rafaeloliva/AEA-DataAcq/SISMEDRG24/v2021-CR1000-RBpi4-Ardu-TB/Papers/CASE2021/PresentCASE2021-Castello+Oliva01-11-21c.pdf

# Vinculación de un sistema de medición con Modbus a través de un enlace MQTT/TLS a un servidor

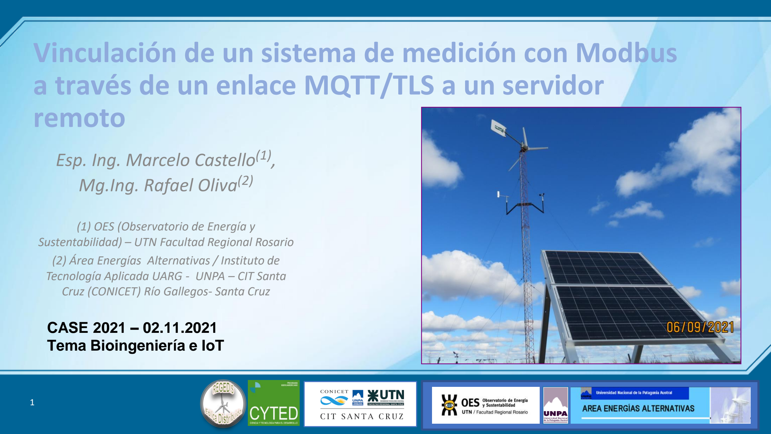
[picture p21: page 1]

1

# remoto

# Esp. Ing. Marcelo Castello⁽¹⁾

,

# Mg.Ing. Rafael Oliva⁽²⁾

## (1) OES (Observatorio de Energía y Sustentabilidad) – UTN Facultad Regional Rosario (2) Área Energías Alternativas / Instituto de Tecnología Aplicada UARG - UNPA – CIT Santa Cruz (CONICET) Río Gallegos- Santa Cruz

## CASE 2021 – 02.11.2021 Tema Bioingeniería e IoT

CASE 2021 – PAPER OES/UNPA 2

# Resumen

- EN ESTE TRABAJO SE PRESENTA LA VINCULACION ENTRE UN DATALOGGER Y UN DASHBOARD CENTRALIZADO.
- EL DATALOGGER, INSTALADO EN EL CAMPUS UNPA-UARG TOMA:
- DATOS DE VIENTO UTILIZANDO SENSORES THIES INSTALADOS EN LA MISMA TORRE DE UN AEROGENERADOR
- INFORMACION DE CORRIENTE PRODUCIDA POR UN CONJUNTO DE PANELES FOTOVOLTAICOS
- INFORMACION DE CORRIENTE PRODUCIDA POR UN AEROGENERADOR DE 1 KW, Y TENSIÓN DE UN BANCO DE BATERÍAS DE 24 V
- EL SISTEMA, A TRAVÉS DE UN INVERTER PROPORCIONA 220 V CA A UN INVERNADERO EDUCATIVO
- SE CONSTRUYÓ UN MÓDULO AUXILIAR EXTERNO PARA MEDICION DE TEMPERATURA Y HUMEDAD EN EL INVERNADERO, COMUNICADO POR RS485 Y PROTOCOLO MODBUS RTU CON EL DATALOGGER PRINCIPAL.
- EL DATALOGGER ENVÍA LOS DATOS A TRAVES DE MODBUS/TCP A UNA RASPBERRY PI 4B QUE CONVIERTE ESTE PROTOCOLO A MQTT/TLS PARA DAR SEGURIDAD A LA TRANSMISION DE LOS DATOS, YA QUE EL SERVIDOR CON EL DASHBOARD SE ENCUENTRA FUERA DE LA RED DE CAMPO.
- SE REALIZA UN ANÁLISIS DE LA PERFORMANCE DEL SISTEMA HÍBRIDO EÓLICO-SOLAR DE BAJA POTENCIA

# Diagramas

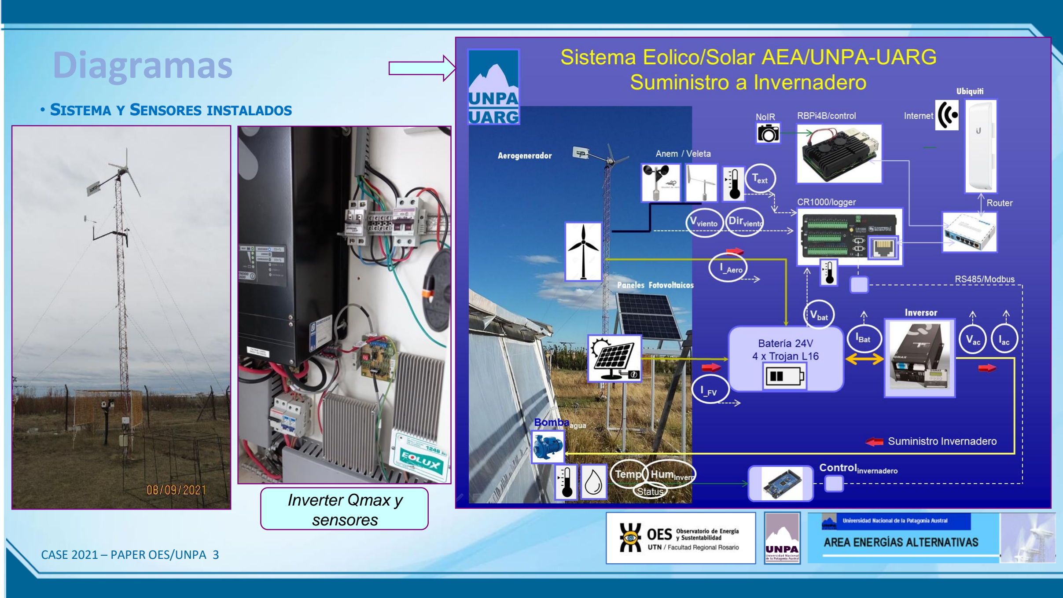
[picture p22: page 3]

- SISTEMA Y SENSORES INSTALADOS

### Inverter Qmax y sensores

# Diagramas

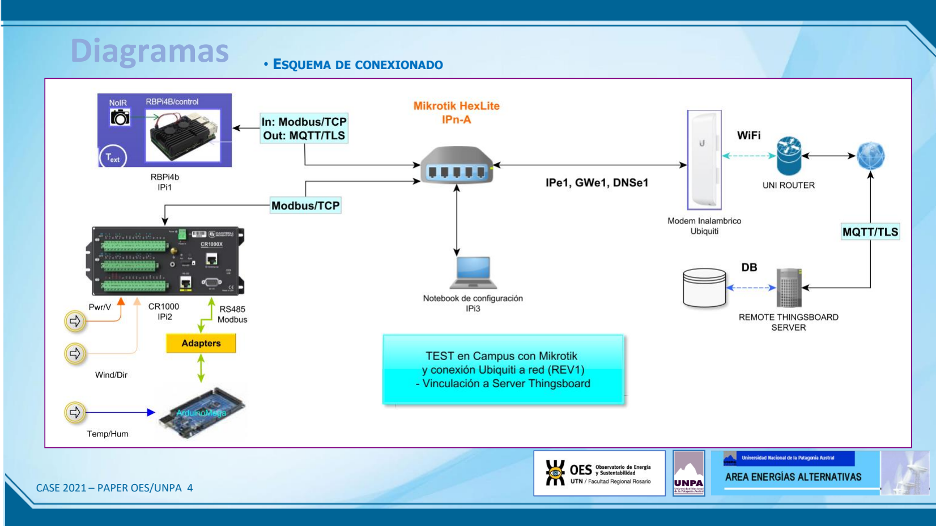
[picture p23: page 4]

- ESQUEMA DE CONEXIONADO

# Implementación

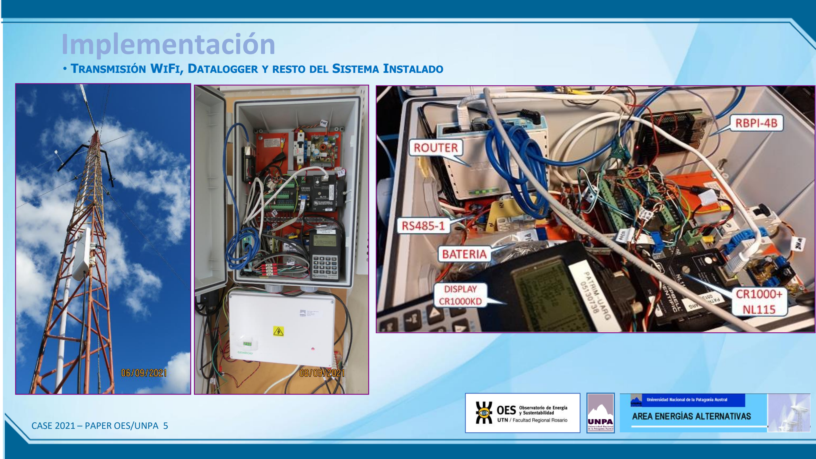
[picture p24: page 5]

- TRANSMISIÓN WIFI, DATALOGGER Y RESTO DEL SISTEMA INSTALADO

# Implementación

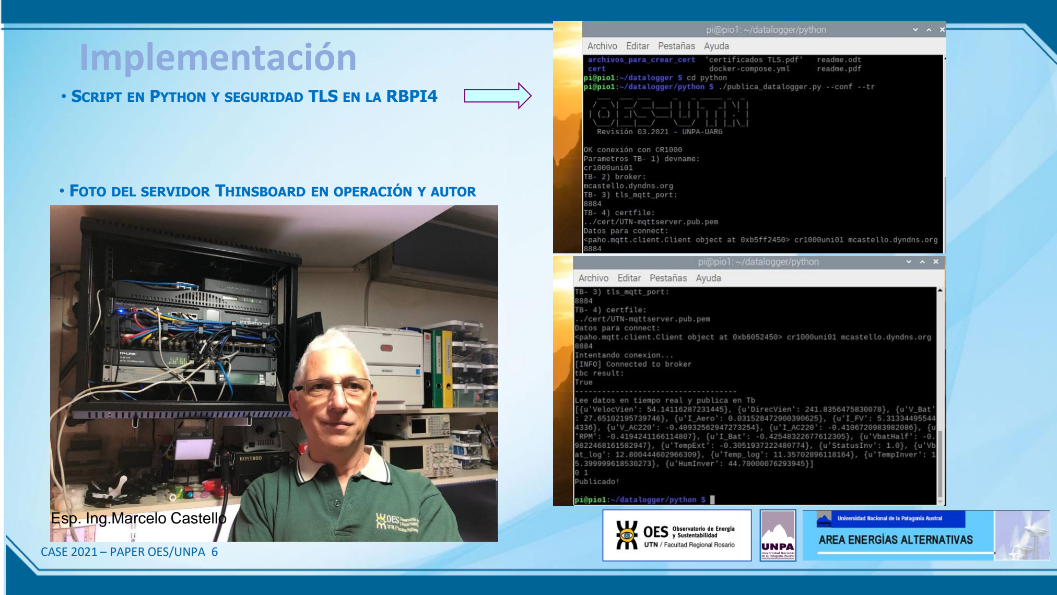
[picture p25: page 6]

- SCRIPT EN PYTHON Y SEGURIDAD TLS EN LA RBPI4
- FOTO DEL SERVIDOR THINSBOARD EN OPERACIÓN Y AUTOR

Esp. Ing.Marcelo Castello

# Implementación

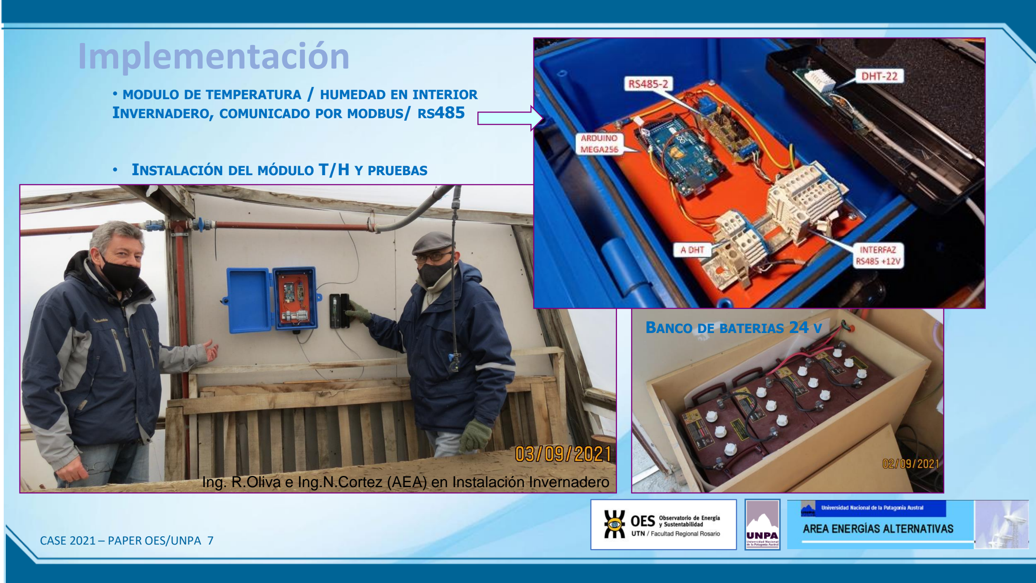
[picture p26: page 7]

- MODULO DE TEMPERATURA / HUMEDAD EN INTERIOR INVERNADERO, COMUNICADO POR MODBUS/ RS485
- INSTALACIÓN DEL MÓDULO T/H Y PRUEBAS

BANCO DE BATERIAS 24 V

Ing. R.Oliva e Ing.N.Cortez (AEA) en Instalación Invernadero

# Datos del panel Thingsboard

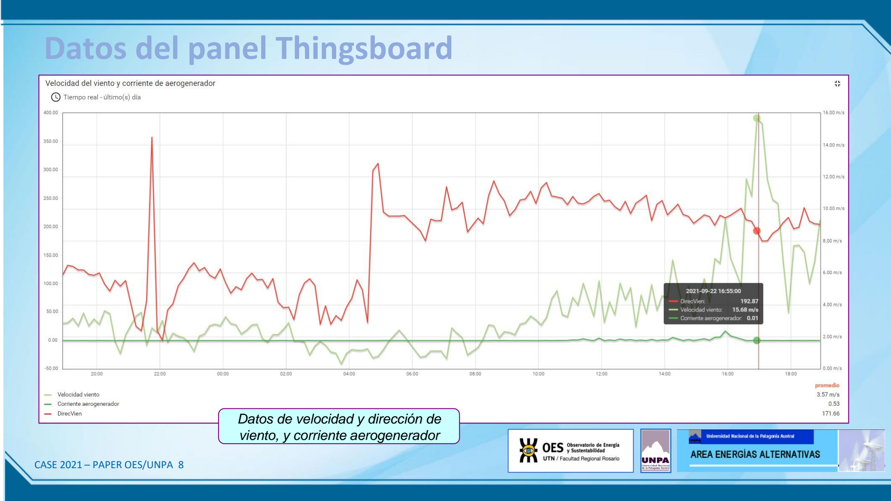
[picture p27: page 8]

- DATOS DE FUNCIONAMIENTO DEL PANEL THINGSBOARD

### Datos de velocidad y dirección de viento, y corriente aerogenerador

# Datos del panel Thingsboard

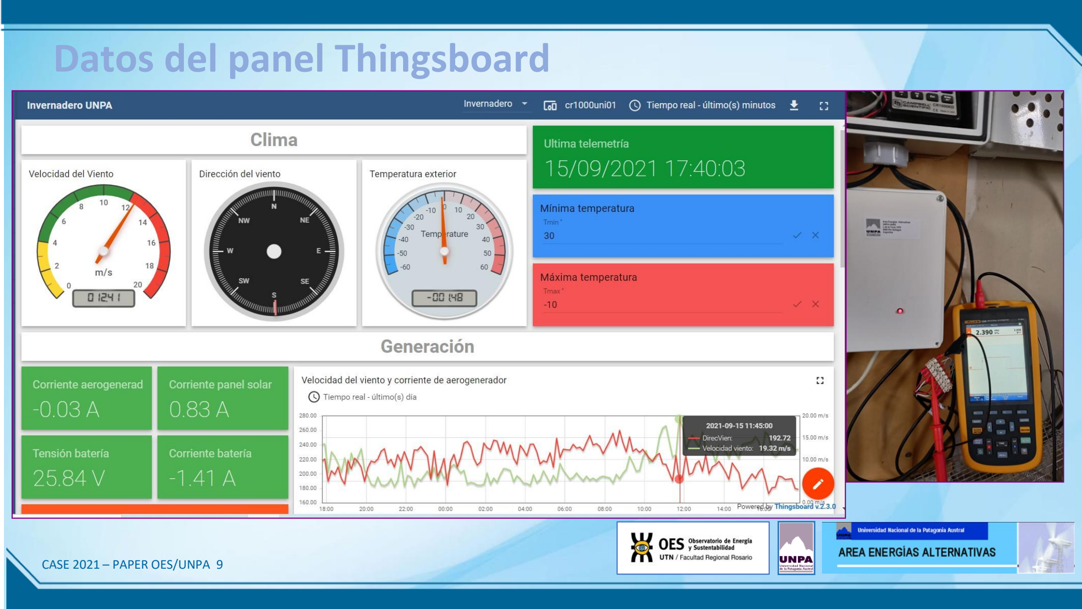
[picture p28: page 9]

- DATOS DE FUNCIONAMIENTO DEL PANEL THINGSBOARD

# Datos del panel Thingsboard

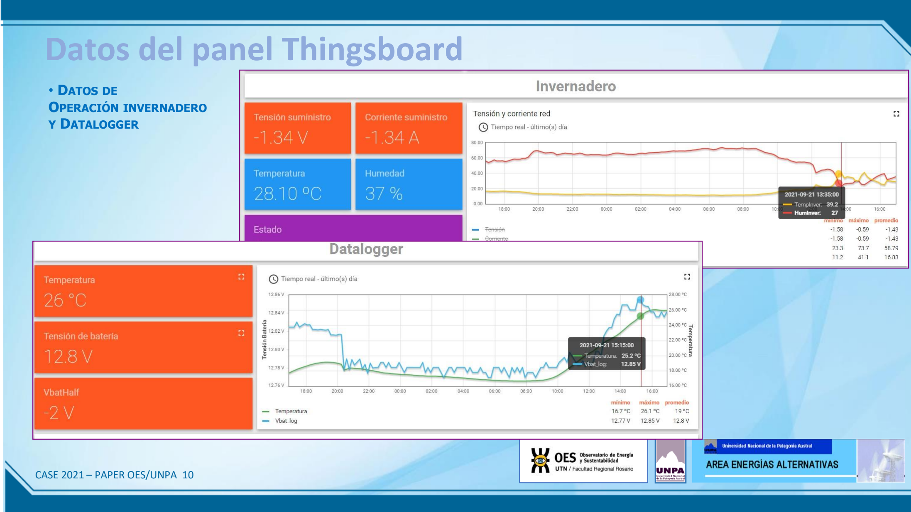
[picture p29: page 10]

- DATOS DE
OPERACIÓN INVERNADERO
Y DATALOGGER

# CONCLUSIONES

- SE HA AVANZADO EN LA IMPLEMENTACION DE UN SISTEMA PARA VINCULAR UN DATALOGGER COMERCIAL A TRAVES DE MQTT/TLS CON UN SERVIDOR REMOTO THINGSBOARD, LOGRANDO MONITOREO Y PERSISTENCIA DE DATOS PARA MEDICIÓN DEL RECURSO EÓLICO Y EL RELEVAMIENTO DE LA PERFORMANCE DE UN SISTEMA HÍBRIDO EÓLICO-SOLAR DE BAJA POTENCIA EN UN CAMPUS UNIVERSITARIO.
- SE ESPERA QUE LOS RESULTADOS CONTRIBUYAN A LA IMPLEMENTACION DE ESTE TIPO DE SISTEMAS EN

INSTALACIONES EDUCATIVAS SIMILARES

# AGRADECIMIENTOS

- LOS AUTORES AGRADECEN A LA UNPA (INSTITUTO DE TECNOLOGÍA APLICADA - UARG), AL CIT-SANTA CRUZ (CONICET) Y AL OES (OBSERVATORIO DE ENERGÍA Y SUSTENTABILIDAD) DE LA UNIVERSIDAD TECNOLÓGICA NACIONAL - FRRO (FACULTAD REGIONAL ROSARIO)
- LA VINCULACIÓN ENTRE INSTITUCIONES HA SIDO UNA CONTRIBUCIÓN IMPORTANTE DE LA RED REGEDIS / CYTED

# Referencias

[1] DATALOGGER CR1000 - CAMPBELL SCIENTIFI C CSI HTTPS://WWW.CAMPBELLSCI.COM/CR1000
[2] RASPBERRY PI 4B (2020) HTTPS://WWW.RASPBERRYPI.ORG/PRODUCTS/RASPBERRY-PI-4-MODEL-B/
[3] UBIQUITI NANOSTATION (2019) HTTPS://WWW.UI.COM/AIRMAX/NANOSTATIONM/
[4] THINGSBOARD COMMUNITY EDITION (2021) HTTPS://THINGSBOARD.IO/
[5] MIKROTIK HEXLITE ROUTERS (2021) HTTPS://MIKROTIK.COM/PRODUCT/RB750R2
[6] DIN-RS485 ADAPTORS USER GUIDE LYR ING. (2021) HTTPS: //WWW.LYRINGENIERIA.COM.AR/WP-CONTENT/UPLOADS/2021/08/USERGUIDEDINRS485BOARD V1DEN.PDF
[7] ARDUINO MODBUS STANDARD LIBRARY (2019) HTTPS://WWW.ARDUINO.CC/EN/ARDUINOMODBUS/ARDUINOMODBUS
[8] POSTGRESQL OPEN SOURCE DATABASE (2021) HTTPS://WWW.POSTGRESQL.ORG
[9] KEYTOOL - ORACLE JAVA PLATFORM TOOLS REFERENCE (2021) HTTPS://DOCS. ORACLE.COM/JAVASE/8/DOCS/TECHNOTES/TOOLS/WINDOWS/KEYTOOL.HTML
[10] FIRSTRATE SENSOR / HUNAN (2021) HTTP://WWW.FI RSTSENSOR.COM.CN/PRODUCT/110.HTML
[11] THIES FIRSTCLASS WIND SENSORS (2021) HTTPS://WWW.THIESCLIMA.COM/EN/PRODUCTS/WIND-FIRST-CLASS/

# Gracias por su atención!
