rafaeloliva/AEA-DataAcq/SISMEDRG24/v2021-CR1000-RBpi4-Ardu-TB/Papers/ReportREGEDIS/REGEDIS_Informe150322.pdf

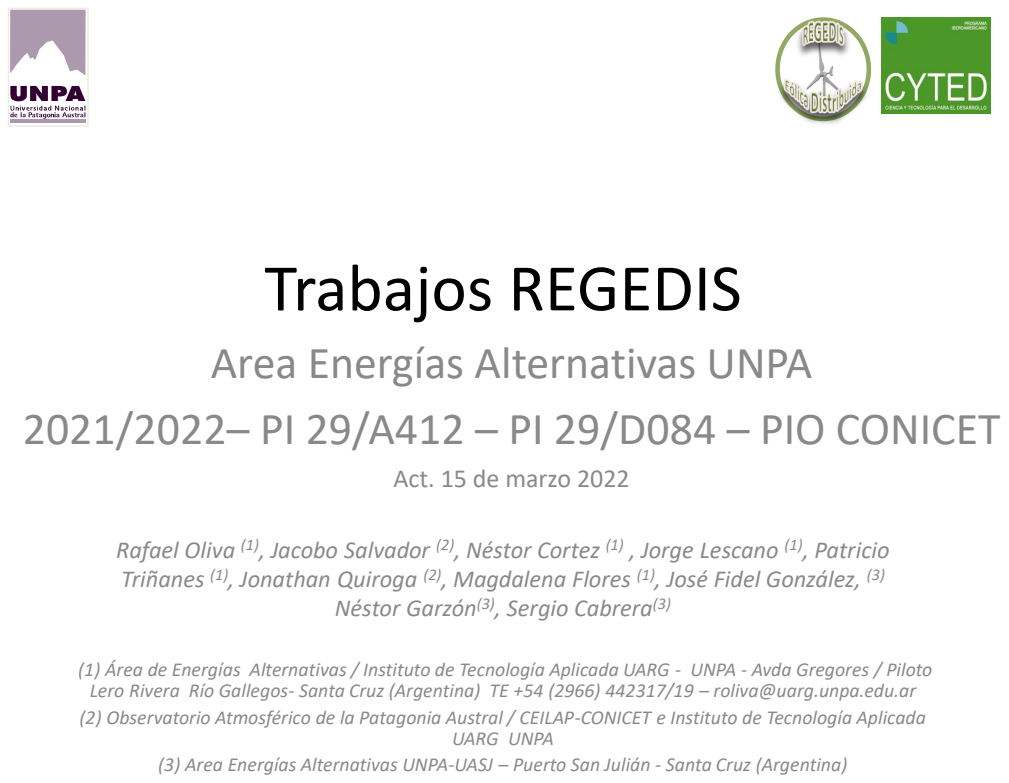
[picture p54: page 1]
UARG UNPA

Trabajos REGEDIS
Area Energías Alternativas UNPA

2021/2022– PI 29/A412 – PI 29/D084 – PIO CONICET

Act. 15 de marzo 2022

Rafael Oliva ⁽¹⁾, Jacobo Salvador ⁽²⁾, Néstor Cortez ⁽¹⁾ , Jorge Lescano ⁽¹⁾, Patricio
Triñanes ⁽¹⁾, Jonathan Quiroga ⁽²⁾, Magdalena Flores ⁽¹⁾, José Fidel González, ⁽³⁾

Néstor Garzón⁽³⁾, Sergio Cabrera⁽³⁾

(1) Área de Energías Alternativas / Instituto de Tecnología Aplicada UARG - UNPA - Avda Gregores / Piloto
Lero Rivera Río Gallegos- Santa Cruz (Argentina) TE +54 (2966) 442317/19 – roliva@uarg.unpa.edu.ar
(2) Observatorio Atmosférico de la Patagonia Austral / CEILAP-CONICET e Instituto de Tecnología Aplicada

(3) Area Energías Alternativas UNPA-UASJ – Puerto San Julián - Santa Cruz (Argentina)

# Invernadero UARG

# Ya con sensores instalados 01-22

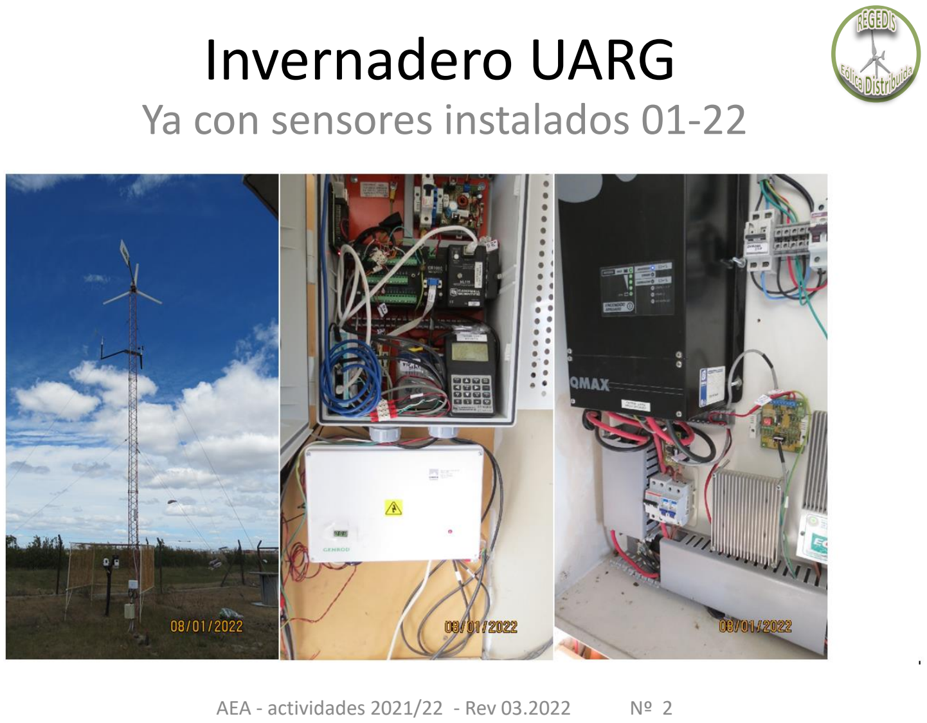
[picture p55: page 2]

AEA - actividades 2021/22 - Rev 03.2022 Nº 2

# Instrumentación

# Ensayos 1

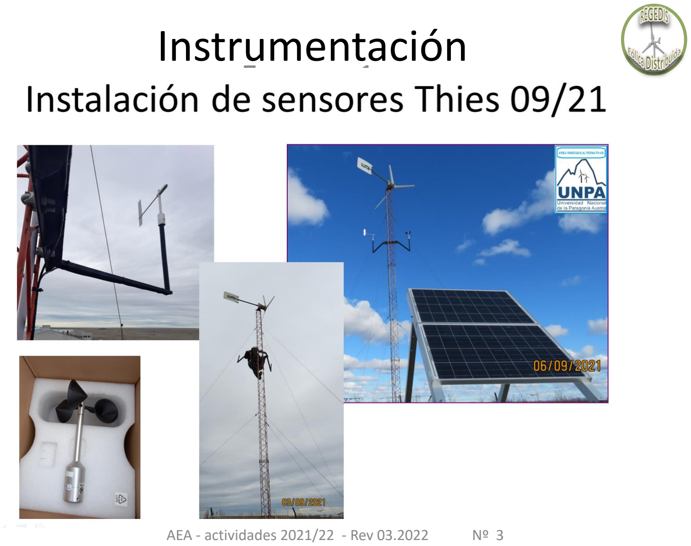
[picture p56: page 3]

# Invernadero UARG

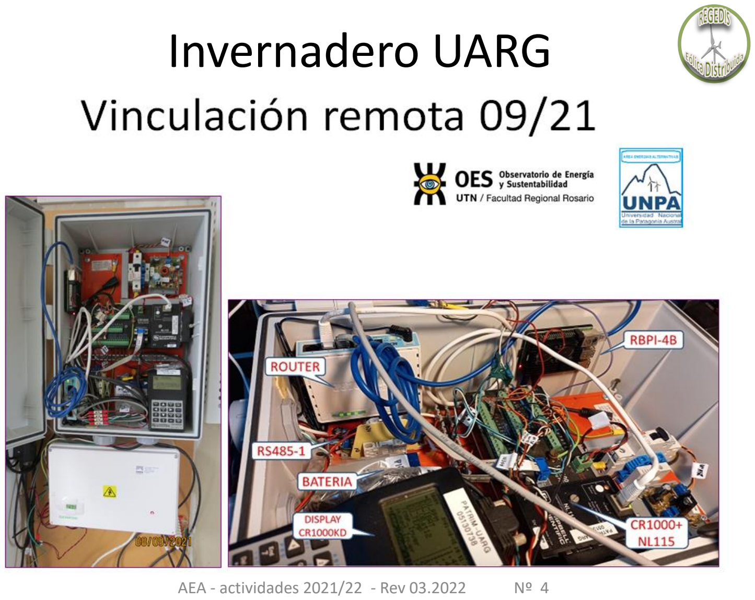
[picture p57: page 4]

## Sistema Eolico/Solar AEA/UNPA-UARG Suministro a Invernadero

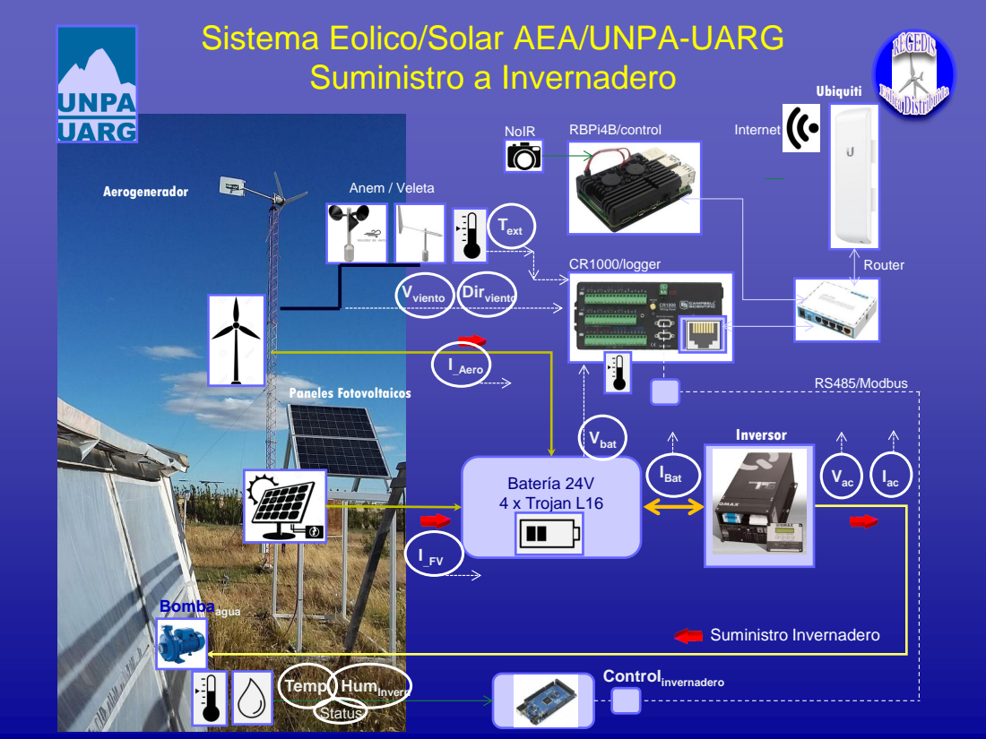
[picture p58: page 5]
Batería 24V 4 x Trojan L16; Aerogenerador; Paneles Fotovoltaicos; Inversor; I_Aero; IBat; Suministro Invernadero; Ubiquiti; RS485/Modbus; Vbat; Vac; Iac; ControIinvernadero; Bombaagua; Temp, HumInvern; CR1000/logger; Router; RBPi4B/control; Anem / Veleta; Vviento; Dirviento; Text; NoIR; Internet; Status

# Instrumentación

# Diagrama 3a

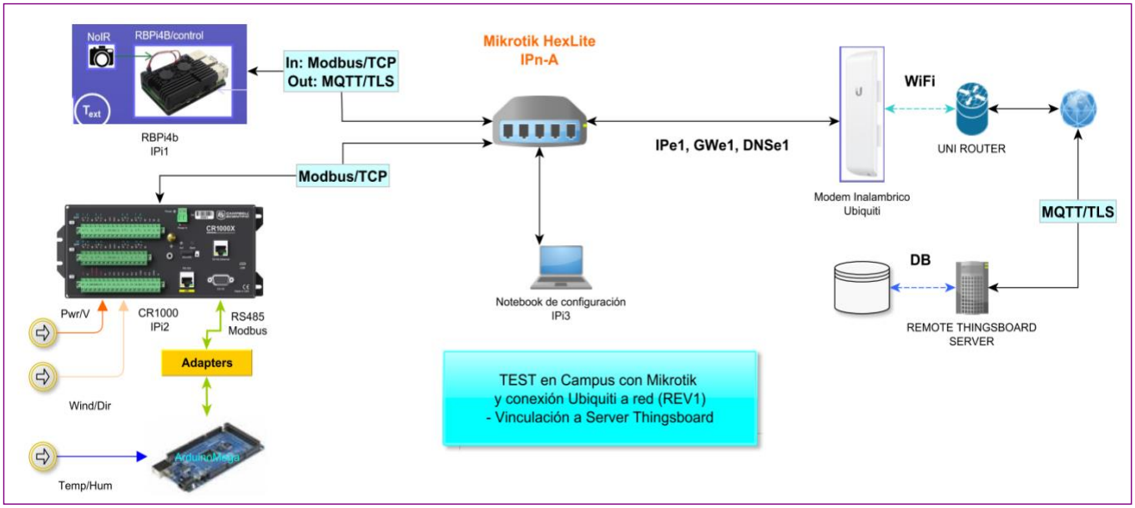
[picture p59: figure]

# Instrumentación

# Diagrama 3b

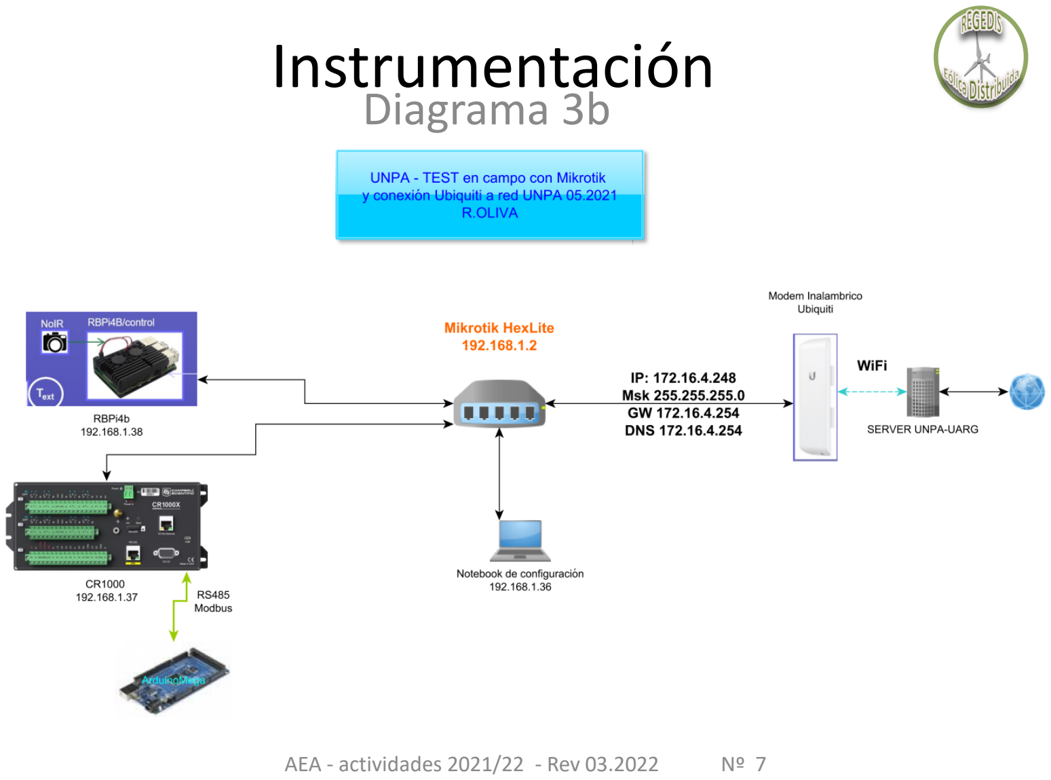
[picture p60: page 7]

# Instrumentación

# Medidor Temp/Hum RS485 a CR1000

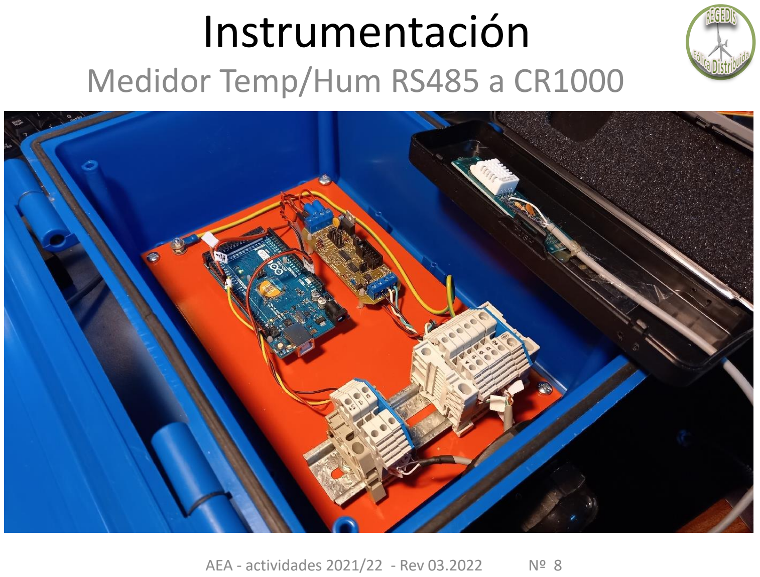
[picture p61: page 8]

# Instrumentación

# Medidor Temp/Hum y sistema bombeo

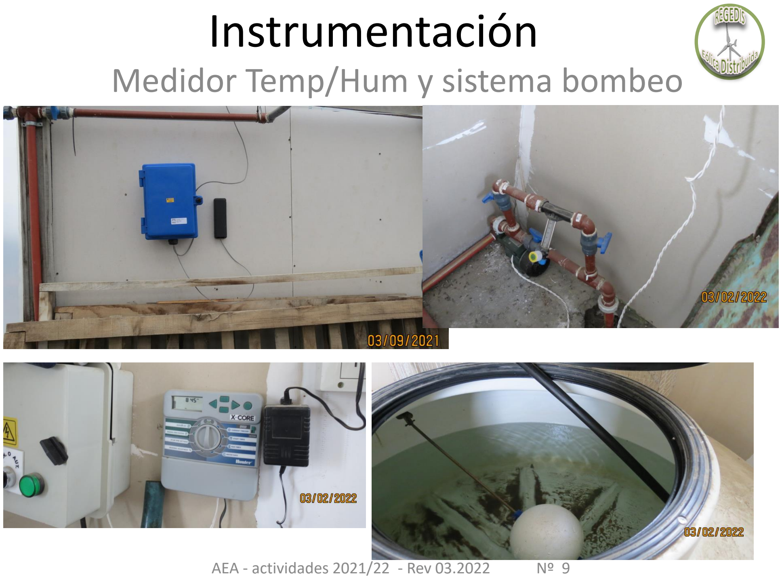
[picture p62: page 9]

# Instrumentación

# Medidor Temp/Hum RS485 a CR1000

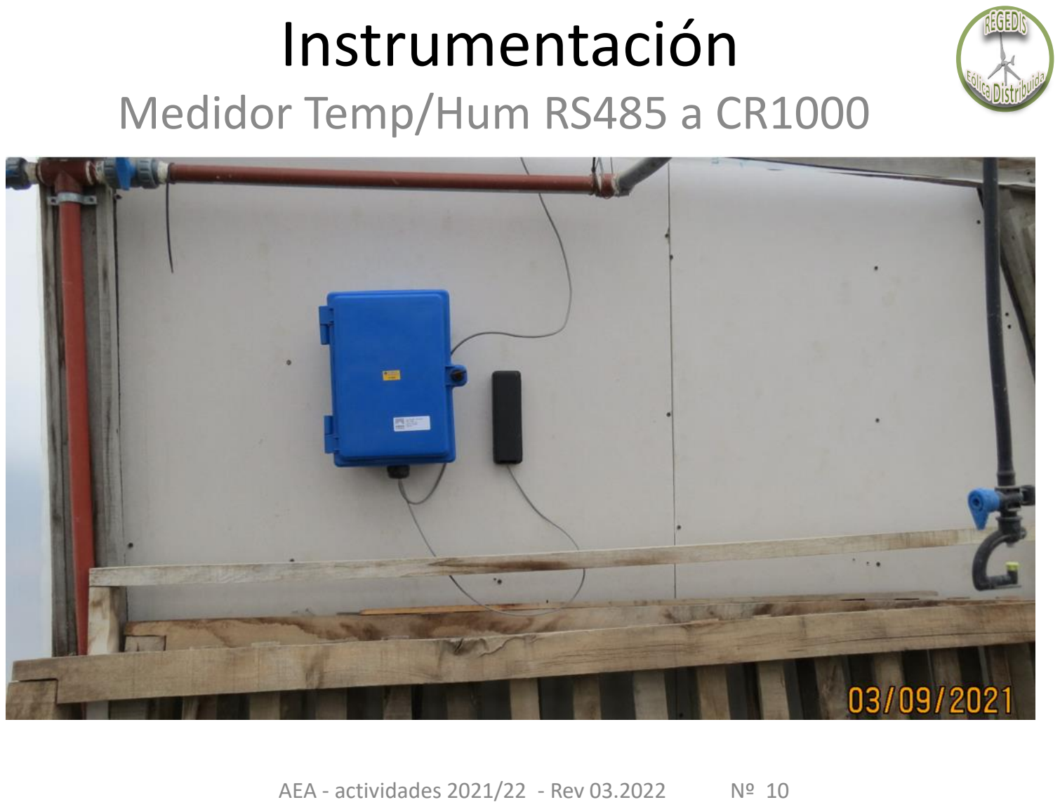
[picture p63: page 10]

# Instrumentación

# Visualizacion datos instantáneos

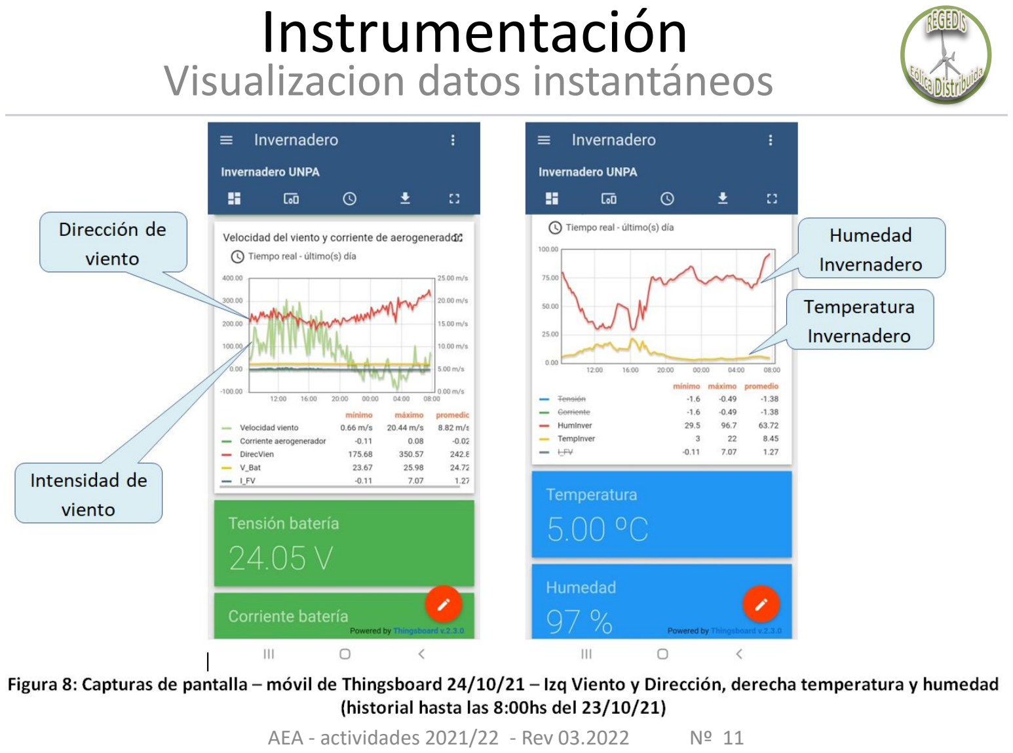
[picture p64: page 11]

# Instrumentación

# Visualización promedios de 1 minuto

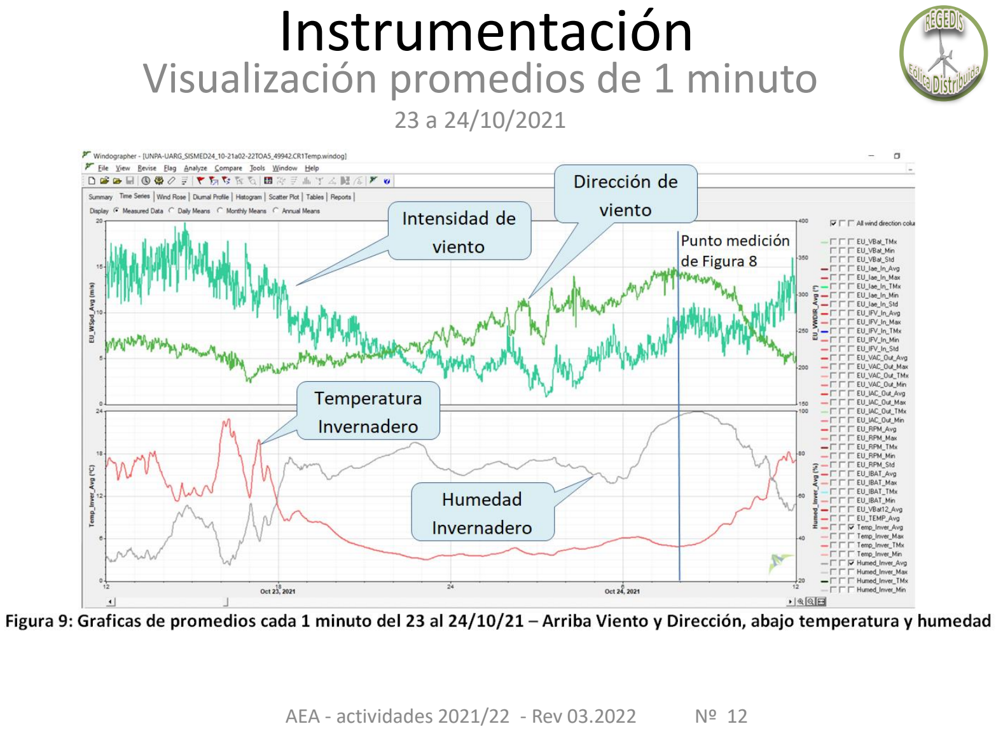
[picture p65: page 12]

23 a 24/10/2021

# Instrumentación

# Datos recientes

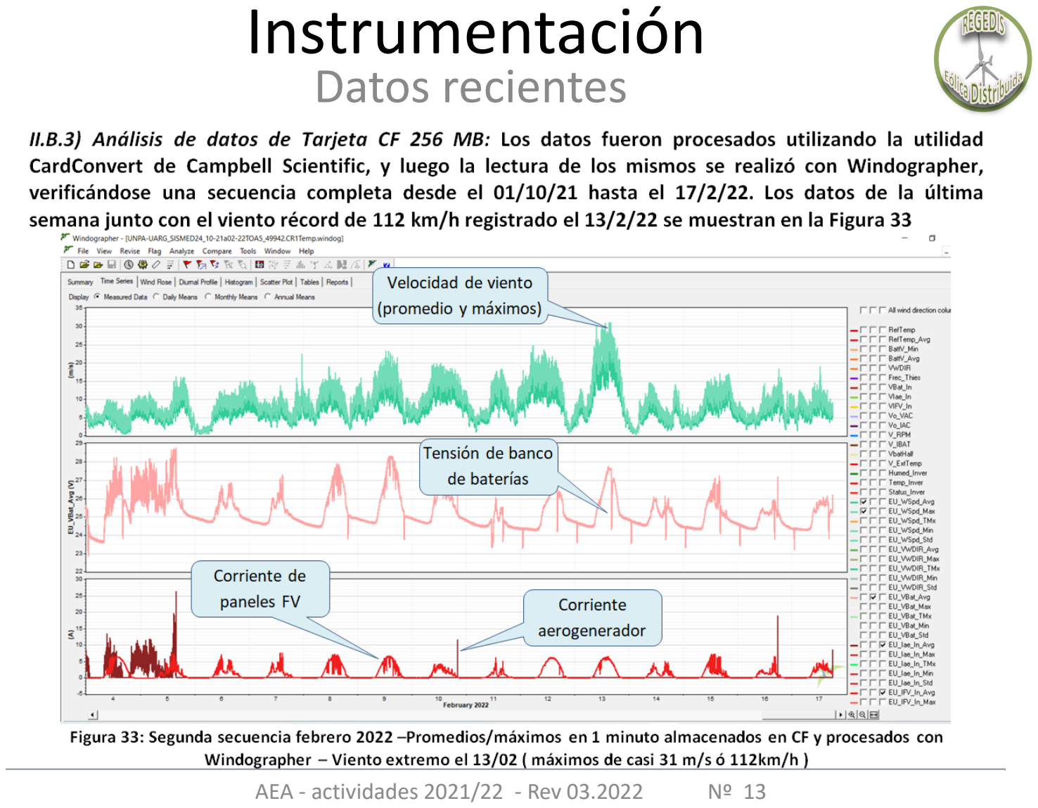
[picture p66: page 13]

# Instrumentación

# Reposición fuente RBPi4

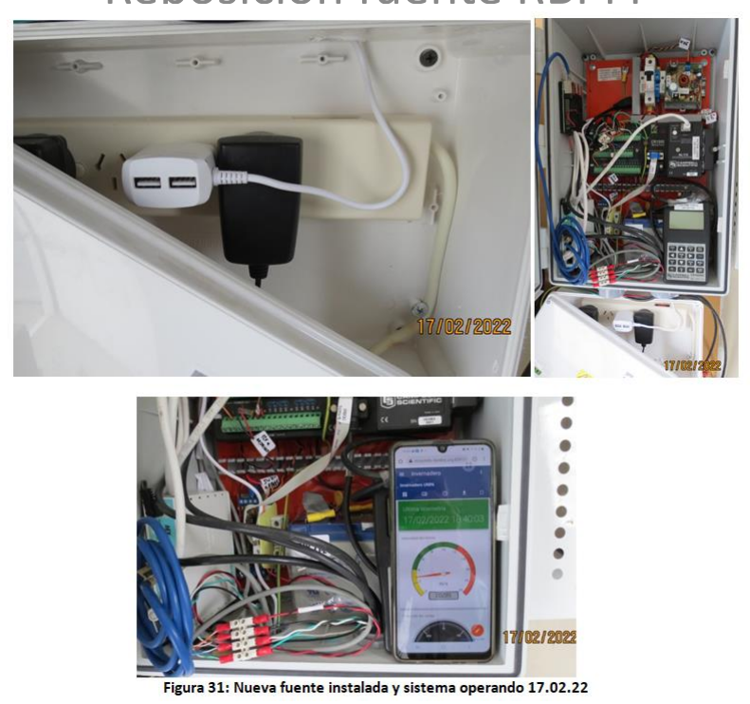
[picture p67: figure]

## Participación R. Oliva como docente en Especialización Eólica UNComa

## Pequeñas Turbinas Eolicas y Sistemas Aislados (7-5-21 a 4-6-21)

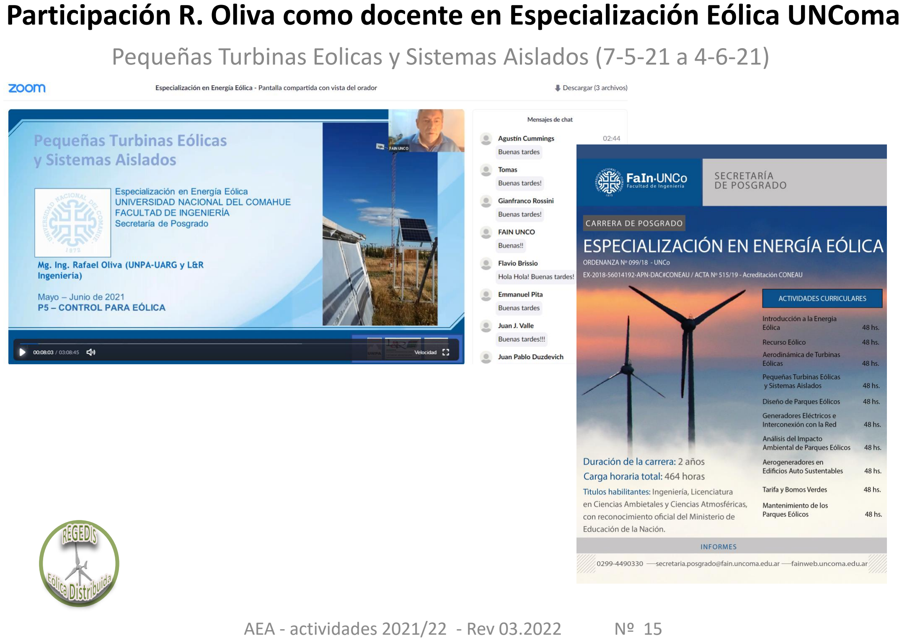
[picture p68: page 15]

## Participación R. Oliva como docente en Magister UMAG

## Módulo Eolica (07-2021)

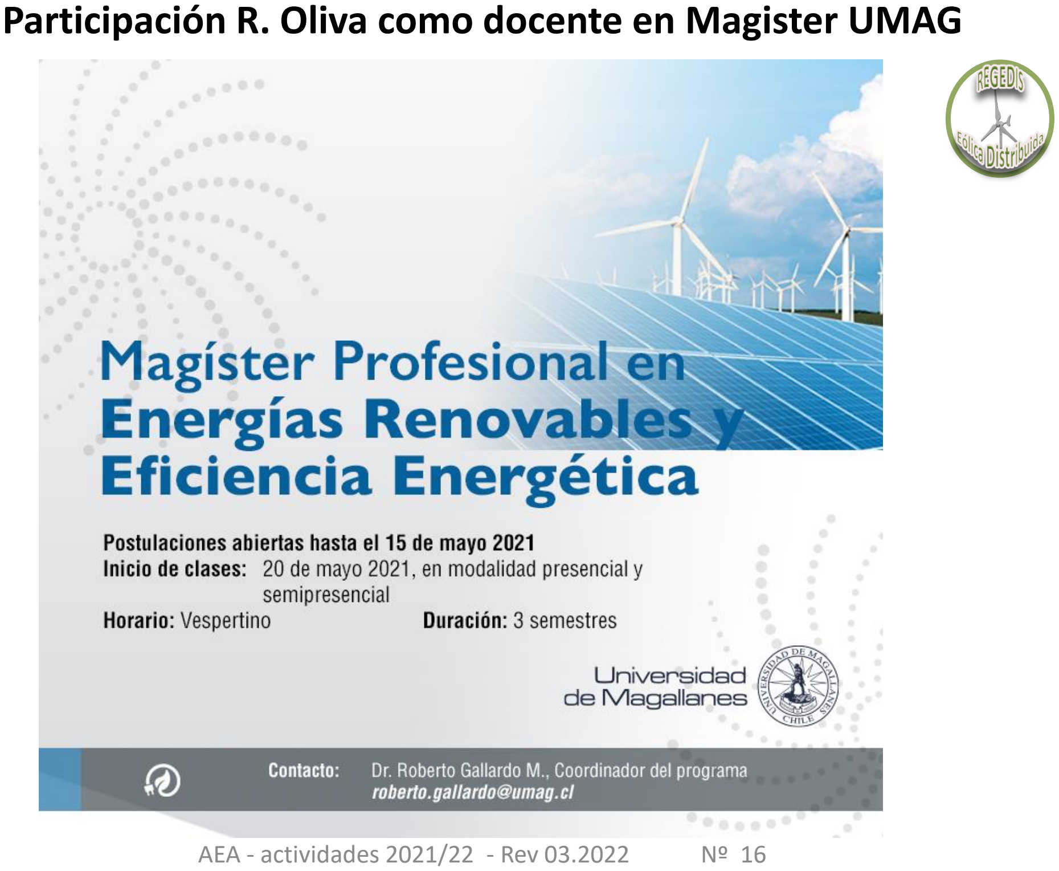
[picture p69: page 16]

# Webinario 08.2021 y actualización de Mini-sitioWeb Area Energías Alternativas

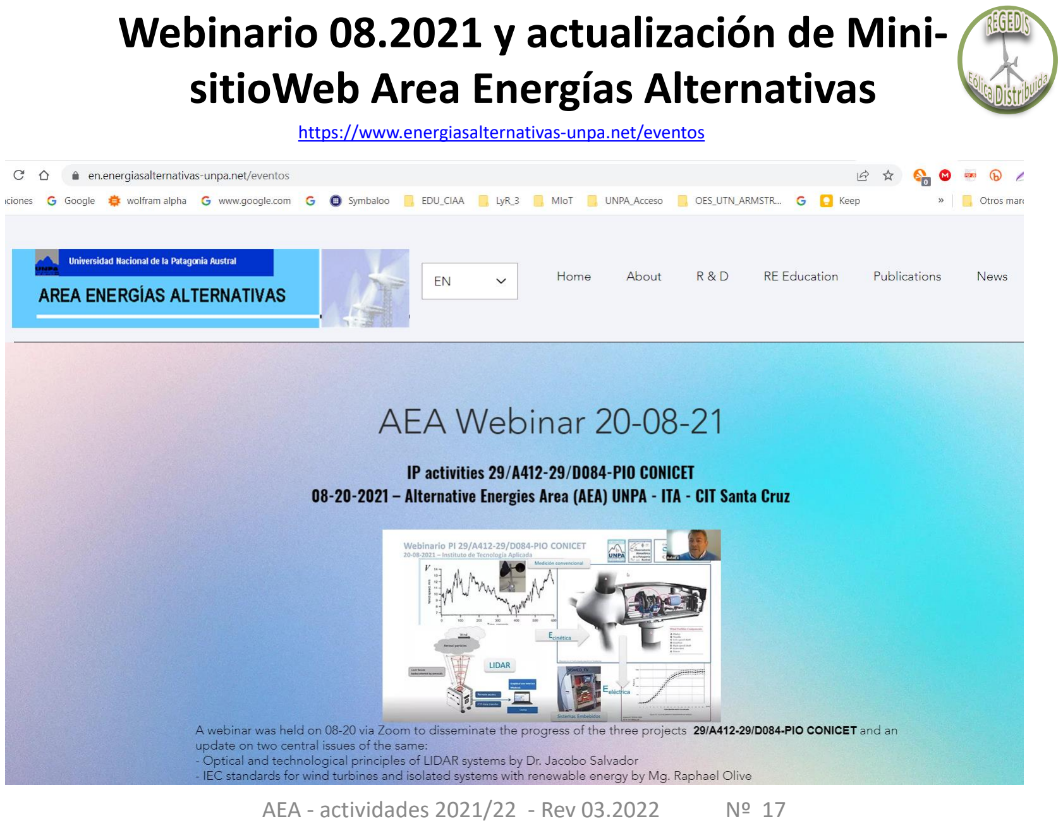
[picture p70: page 17]

https://www.energiasalternativas-unpa.net/eventos

## Participación Instrumentación equipos VAWT700 UMAG

01/2022

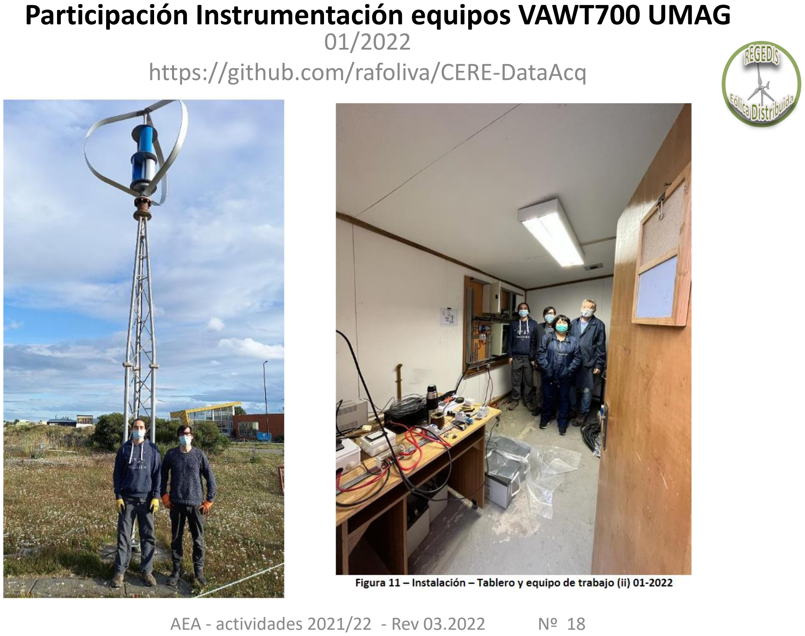
[picture p71: page 18]

## https://github.com/rafoliva/CERE-DataAcq

# Gracias por su atención
