rafaeloliva/AEA-DataAcq/SISMEDRG24/v2019-CR1000/CR1000_yEdFlowCharts/CR1000Uni_Main_v11-10-2019b.pdf

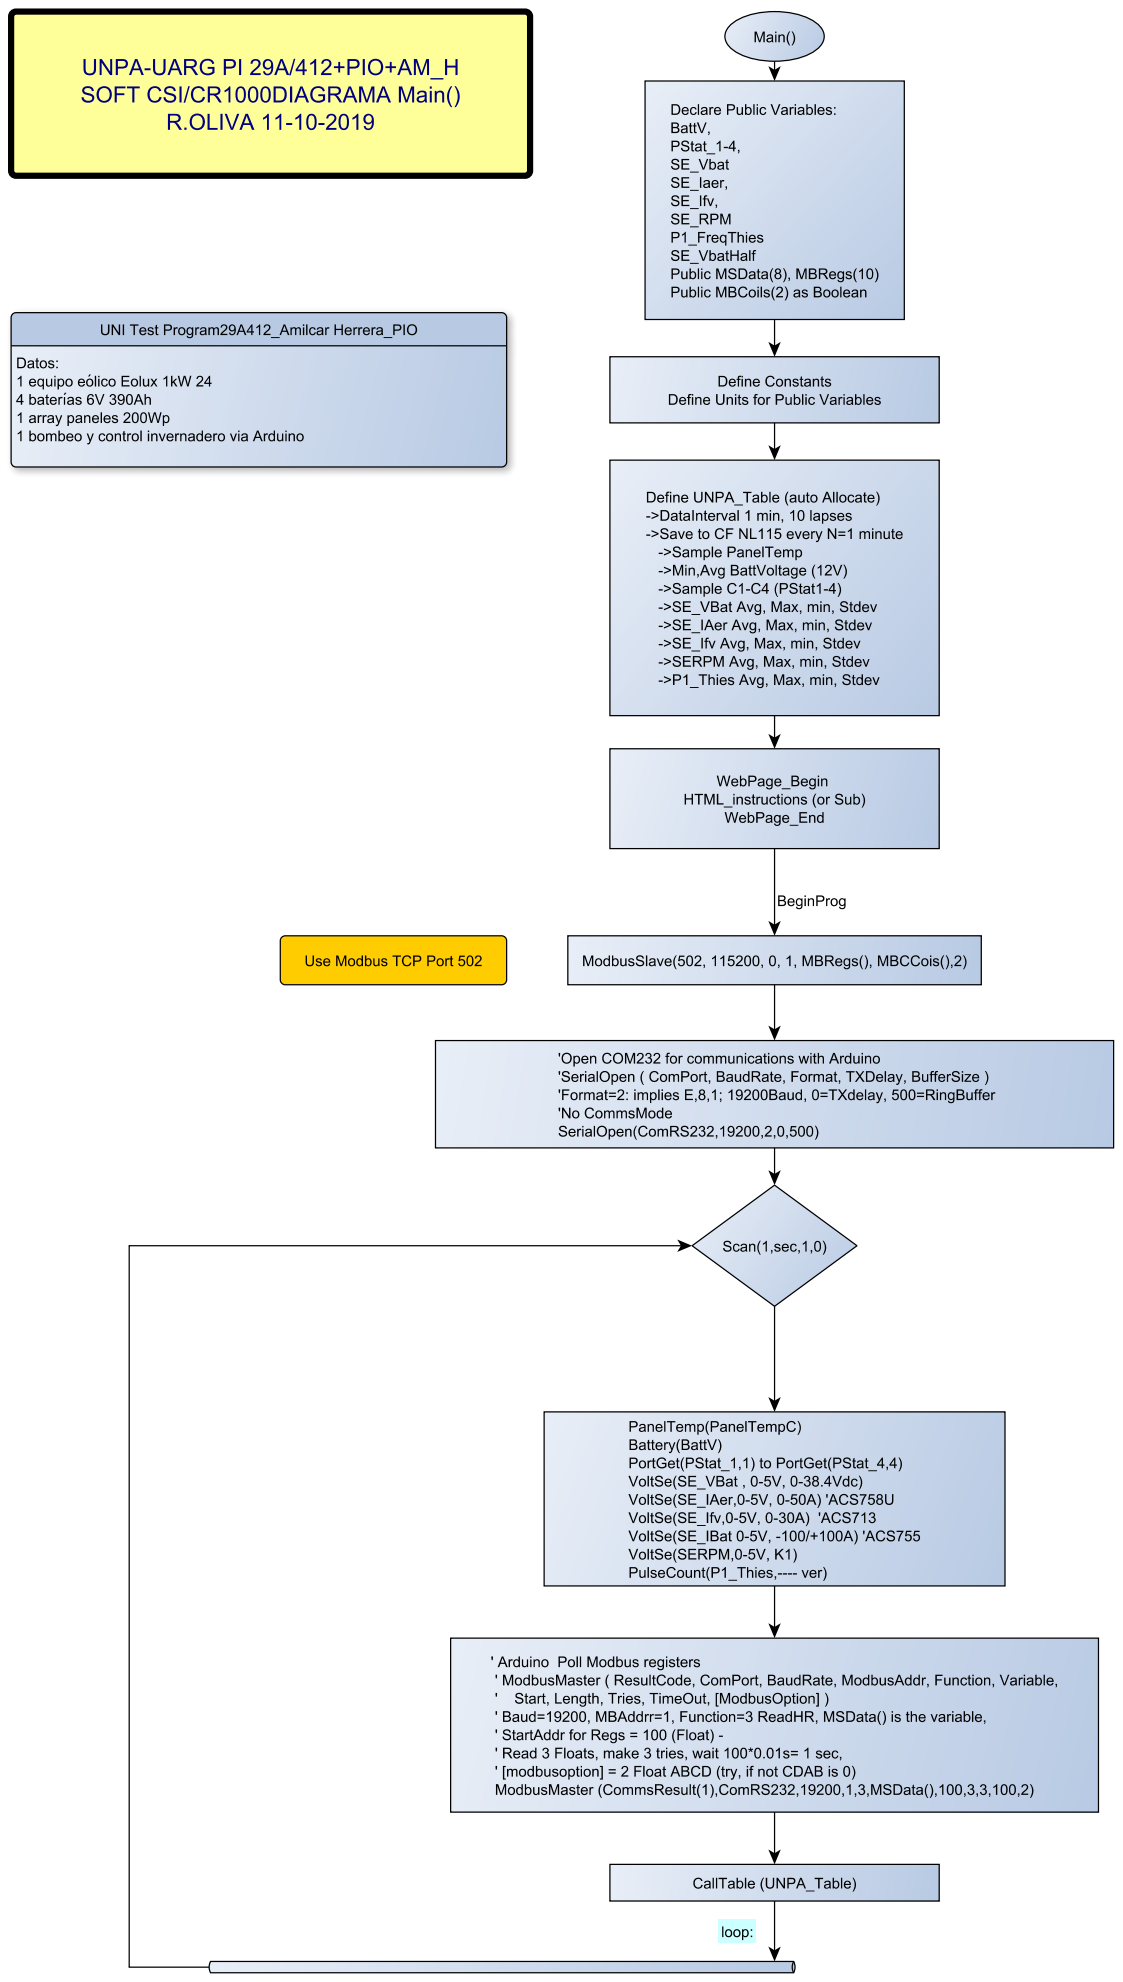
[picture p72: page 1]
