rafaeloliva/AEA-DataAcq/SISMEDRG24/v2021-CR1000-RBpi4-Ardu-TB/CR1000-RBpi4-Arduino-yEdFlowCharts/CR1000Uni_Main_v2b(11-03-2021).pdf

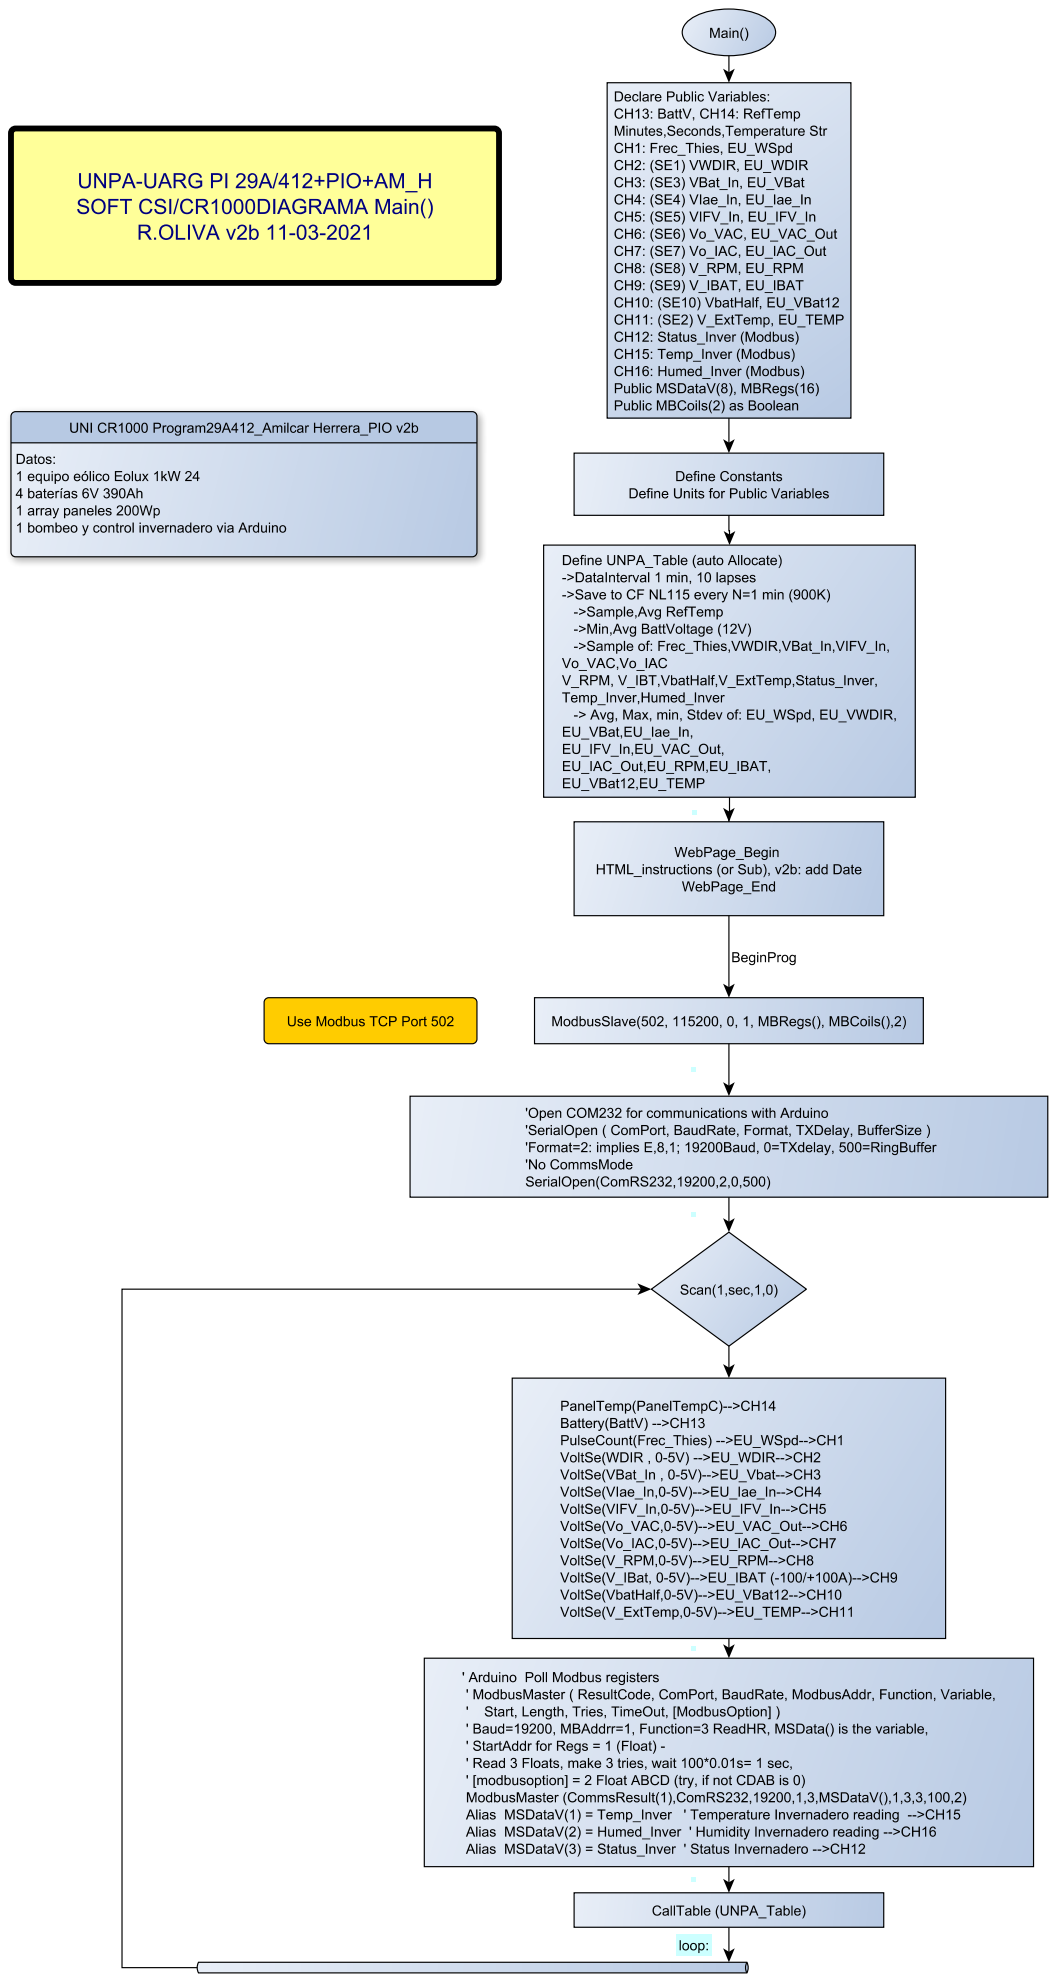
[picture p73: page 1]
