rafaeloliva/AEA-DataAcq/SISMEDRG24/v2021-CR1000-RBpi4-Ardu-TB/SystemDiagram/Uni_CR1000+RBpi4+Routers(2-conMikrotik+Ubiquiti).pdf

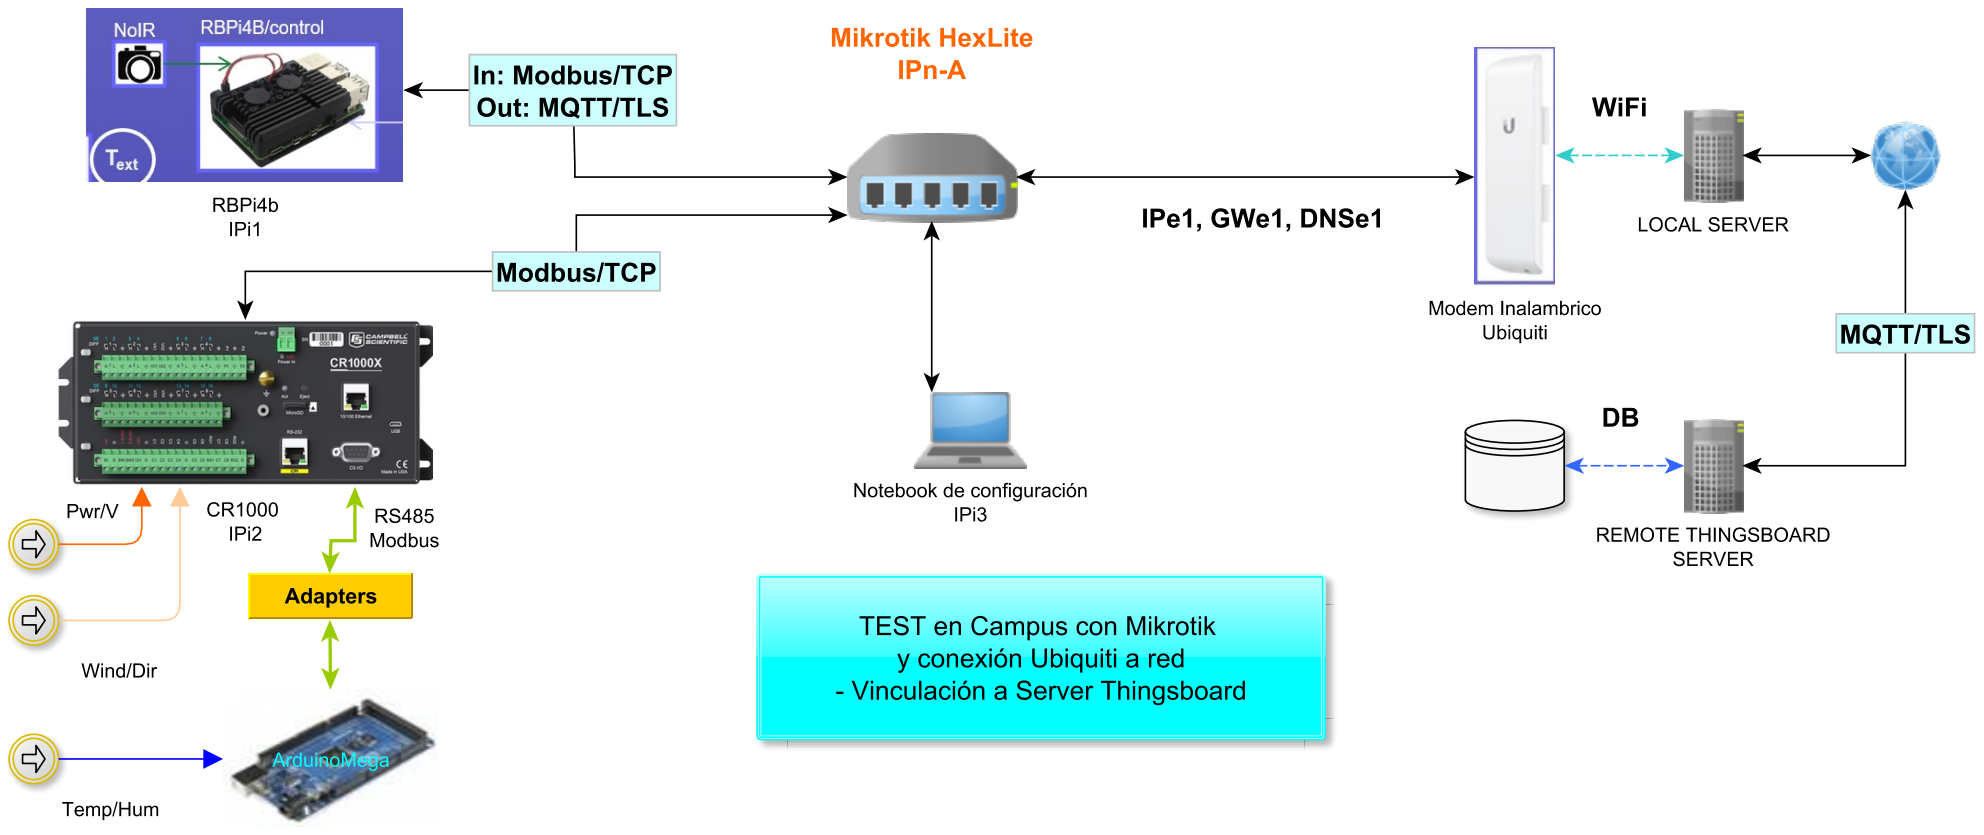
[picture p74: page 1]
